1103576292pjhq-pixel/kwt/docs/reports/20261018-fixed-point-v1/README.md

# 定点方案比较与完整验证摘要

本目录归档 2026-10-18 实验 `20261018_fixed_point_v1` 的精简结果，不是本次资料整理重新运行的完整数值评测。完整矩阵、参数及原始比较明细仍在工作区 `generated/`。

尺度从 221 条训练输入的范围确定，增加 12.5% 幅值余量，再冻结配置。独立验证子集有 221 个输入；没有根据验证结果重新拟合尺度。模型固定提交为 `237e4097afd4f6851e0b82f0a8d65c2dfe8eae30`。

| 输入×权重 / 累加 / 输出 | 舍入 | 验证子集最差层 NRMSE | 验证子集最差单任务 NRMSE |
| --- | --- | ---: | ---: |
| 8×8 / 32 / 16 | RNE | 2.62043% | 4.11960% |
| 8×8 / 32 / 16 | 向零 | 5.67256% | 6.80097% |
| 16×8 / 32 / 16 | RNE | 2.36506% | 3.76023% |
| 16×8 / 32 / 16 | 向零 | 3.90772% | 5.45364% |
| 8×16 / 32 / 16 | RNE | 1.38383% | 1.71332% |
| 8×16 / 32 / 16 | 向零 | 3.06266% | 3.37268% |
| 12×12 / 32 / 16 | RNE | 0.16511% | 0.25230% |
| 12×12 / 32 / 16 | 向零 | 0.39294% | 0.50151% |
| 16×16 / 40 / 16 | RNE | 0.02064% | 0.03199% |
| 16×16 / 40 / 16 | 向零 | 0.04932% | 0.07298% |

选择 `i16_w16_a40_o16_rne` 作为起点，是为了精度余量和自然的 16 位存储；尚未证明它是面积或速度最优方案。12 位方案可作为后续资源对照。层汇总通过不保证每个矩阵任务通过，例如 8×8 的最差层低于 3%，但最差单任务高于 3%。

## 冻结后完整验证划分

- 原模型十二分类验证索引共 4445 条记录，实际计算 4075 个不同输入；一个全零波形按 371 条原始静音记录加权。
- 十二层最差汇总 NRMSE 为 **0.0211055%**；最差单输入、单层矩阵任务为 **0.0319907%**。
- 输入、输出、累加和偏置饱和计数全部为零，所有部分和界证明安全。
- 模型 162 个实际参数张量与 checkpoint 核对一致。

NRMSE 由平方误差和参考能量计算，不是分类错误率。4445 是原模型十二分类划分记录数，不是整个 35 词原始验证 WAV 数量。未用测试音频调参。

## 文件与复现入口

| 文件 | 含义 |
| --- | --- |
| [candidate_scales.json](candidate_scales.json) | 训练冻结的十组候选配置，保留原字节及历史工作区路径 |
| [comparison-summary.json](comparison-summary.json) | 十方案的训练/验证汇总；包含原 comparison.json 的 SHA-256 |
| [full_validation.json](full_validation.json) | 完整验证各层误差、计数、范围和原运行源码哈希 |
| [historical-audit.json](historical-audit.json) | 原运行审计记录；其中 19 项测试指历史运行 |
| [archive-manifest.json](archive-manifest.json) | 上述归档 JSON 的 SHA-256 |

配置文件 SHA-256：`d208f34b17da4db0a32fbdf21904e9c1739062f5389e24134e6f78a298f3e58a`。历史哈希用于核对原运行，不应在修改源码后重写。当前维护规格见 [数值格式 v0.1](../../shared/numeric-format-v0.1.md)。

重建数据需按 [环境说明](../../../config/environment/README.md) 准备模型和音频，再使用 `scripts/model/analyze_training_ranges.py`、`compare_fixed_point.py`、`full_fixed_point_validation.py`；先看各脚本 `--help`，新实验使用新的输出目录，勿覆盖原结果。

TensorFlow CPU 2.4.0 替代原始 2.4.0rc1，运行时等价性未证明。这些结果仅覆盖 FFN 第一线性层的数值模型；没有 RTL、面积、150 MHz 时序、整模型量化分类准确率或正式评测通过结论。
