1103576292pjhq-pixel/kwt/docs/reports/20261023-v07-accelerator/README.md

# 2026-10-23 V07独立加速器验证记录

本记录只针对`worktrees/ffn-v07-peripheral`中的本次实现。未合并、未推送；不是官方任务、真实语音精度、工艺面积或150MHz验收结论。

## 已执行并通过

| 测试 | 范围与结果 |
|---|---|
| 原计算核心 | 400 lane乘积；251转换用例加12拍连续转换；45块、1904输出握手 |
| 行为存储 | READ_LATENCY=1和2；各8480项X/W lane与bias检查 |
| 行为整机小矩阵 | M5/N32、两层；320项Y/flags/index，覆盖尾行、连续命令、背压、完成当拍BEGIN、非法命令和恢复 |
| 行为整机完整尺寸 | M99/N256、12个独立层任务；304128项Y/flags/index；第3个及之后的OPEN实际等待槽释放 |
| 实际宏小矩阵 | READ_LATENCY=1、M5/N32两层；存储8480项、整机320项通过 |
| 实际宏完整尺寸 | READ_LATENCY=2、M99/N256一层；存储8480项、整机25344项通过 |
| 两个整数参考交叉 | 12层304128项golden Y与个人fixed_point.py一致；Y及flags与队友fixed_numeric.py一致 |
| 个人整数模型测试 | test_fixed_point.py 7项通过 |
| 通用门级试综合 | Yosys0.9；默认M99/N256，USE_MACRO=1；hierarchy/check通过，12颗宏、未检测到锁存器 |

完整尺寸测试使用固定种子20261023的合成整数数据，交替小幅值/全范围数据，并含零行、正负bias、tie、饱和和任务身份差异；不把它说成12套真实预训练参数验证。生成目录manifest记录每个输入与golden文件的SHA-256。

## 试综合范围

使用本地`TS1N28HPCPL2SVTB2048X32M4MWBASO_tt1v25c.lib`作为SRAM库，12颗宏全部保留。每颗2048×32=8KiB，总物理实例容量96KiB；W的逻辑载荷虽只有4KiB，不能按4KiB计宏面积。

Yosys `synth -noabc`及`check -assert`通过。通用门级统计：61165 cells，含5007个$_DFF_P_和12颗SRAM宏；其余为通用AND/OR/XOR/NOT/MUX。未做标准单元映射、时钟约束、STA或功耗估算，不用通用门数推算正式mm²。

Yosys有两类预期警告：短的data_pipe/mask_pipe数组被转换为寄存器列表。这里是延迟寄存器，不是把X/W SRAM展开为触发器；最终12颗宏计数另行检查。

## 警告与限制

- 实际宏UNIT_DELAY模型在仿真0时刻报CEB初始化/退出shutdown顺序警告。未屏蔽警告，未修改宏模型；正常加载、运行、复位及中止流程功能比对通过。上电/睡眠/关断时序不在本版验收范围。
- 当前matrix_ctrl一次一个读请求在途，返回暂存后再供数；行为RAM一拍延迟时稳定供数间隔约3拍，两拍延迟约4拍。尚未实现每拍一组的预取优化。
- 没有64项结果缓冲，输出背压会延长当前块占用时间；这是已确定的初版组织。
- 独立输出握手表示接收方消费；未来SoC实际写回完成仍需总线层协议。

## 审阅与修正

独立只读审阅检查模块边界、槽释放、标签、尾行、背压和中止；指出完成周期BEGIN语义及测试缺口。新增测试先复现完成当拍BEGIN误报fault，再修正frontend与busy；补充连续命令、计算/受阻输出阶段协议故障取消测试，随后重跑完整12层。

## 依赖与隔离

四个计算文件和公共头文件与导入快照逐字节一致，没有改动。执行期间原计算工作树的mul_array_4x4.v被其他工作新增注释，本工作树保留已验证快照；其余四份依赖仍与源目录一致。这一源目录注释变化没有迁入本分支。

本地试验宏、下载的临时Yosys工具及大规模向量/网表均不放进源码提交，工具与产物分别在忽略的work/和out/中。接口与完整命令见../../shared/accelerator-v07-interface.md。
