1103576292pjhq-pixel/kwt/readme_sdc&scr.md

针对accelerator_top构造了可成功运行的flow与sdc。
WLM model：ZeroWireLoad   WLM mode：segmented
