1103576292pjhq-pixel/kwt/tests/fixtures/dot64-integration-v0.1/README.md

# 完整点积核心集成测试向量

共33个固定数值用例，无新增随机用例，也不需要重新下载音频或模型。

- 编号0～11：来自 `../dot64-v0.1/layer_00.json` 至 `layer_11.json`，为已有软件数值验证保存的12层真实诊断点积。原文件保留样本身份、行列位置和浮点参考；此处使用已量化的整数输入及整数期望值。
- 编号12～29：来自 `../dot64-v0.1/boundaries.json` 的18个人工边界用例，覆盖零、正负RNE半值及附近值、偏置边界、输出饱和、抵消和最后一项。
- 编号30：64对输入均为 x=256、w=256，bias=655360。累加后4849664，输出74。
- 编号31：64对输入均为 x=-256、w=256，bias=655360。累加后-3538944，输出-54。
- 编号32：仅k=63的x=w=256，其他输入均为0，bias=0。累加后65536，输出1，用于检查是否遗漏最后一个乘积。

前30个期望值沿用原固定向量，其来源清单记录了与 `scripts/model/fixed_point.py` 的交叉核对。新增3个期望值来自人工整数计算。本次入库又使用Python任意精度整数重算全部33个点积，并用 `divmod(acc,65536)` 的商、余数执行最近取整、中间值取偶数，再限制到[-32768,32767]；结果与保存的期望值一致。没有使用RTL输出生成期望值。

`x.hex`、`w.hex`各2112行，按用例编号依次排列，每例内部按k=0～63排列。其余3个hex文件各33行。所有文件均为定宽补码十六进制编码。`manifest.json`记录顺序、3个新增用例的完整输入、来源和SHA-256。

复位、中途clear、连续任务、输入暂停和DONE采样属于TB施加的时序场景，不是另外的音频或随机数值样本。33例之后，两次中止恢复检查分别复用第30、31例，因此共完成35次完整任务。

合法的64个signed16乘积加signed32偏置不会溢出signed40；这些外部输入不声称覆盖40位累加饱和事件。功能仿真不证明150MHz时序、面积或完整矩阵精度达标。
