1103576292pjhq-pixel/kwt/(commit log)

2026-10-16 feat: add KWT-1 accelerator prototype and validation reports
    Include the integer FFN1, public E203 integration, FP32 attention and
    twelve-layer encoder, pinned dependencies, and local validation evidence.
    Document all seven tasks, reproducible entry points, and formal evaluation
    items that remain pending. Restore four pinned upstream links during Linux
    preparation so Windows Git can manage the repository without LX symlinks.
    [case-results.csv, command-results.tsv, commands.tsv, layer-results.csv, rtl-case-results.csv, rtl-layer-results.csv]
2026-10-23 feat: add standalone V07 FFN1 accelerator with verified matrix pipeline
    Import the byte-verified modular INT16/Q12 x INT16/Q16 accelerator, software numeric model, fixtures and reproducible tests. Full M99 N256 twelve-layer synthetic regression checks 304128 Y/flags/index records; core, latency1/2, SRAM model and integer-reference checks pass. Document the standalone entry and differences from the historical SoC.
    [acc_context_bank.v, dot64_tile_core.v, mul_array_4x4.v]
2026-10-23 chore: keep standalone accelerator only and add synthesis entry
    Remove the historical team tree from this branch only. Keep the imported standalone RTL byte-identical, provide a canonical 12-file RTL list, Tcl source variables, a 150 MHz clock template and synthesis instructions. Verify import hashes, file-list compilation, Tcl parsing, core/buffer/accelerator tests and generic synthesis with 12 SRAM macros and no latches. Formal mapped timing/area remain pending.
    [analysis.csv, case-results.csv, classification.csv, command-results.tsv, commands.tsv, layer-results.csv, layer_metrics.csv, rtl-case-results.csv]
2026-10-25 feat: sync Verilog-2005 accelerator and LVT SRAM configuration
    Import the latest dot64-core development snapshot, replace peripheral .sv paths with .v, and align SRAM cell/model/Liberty references to TS1N28HPCPL2LVTB2048X32M4MWBASO tt0p9v25c. Update synthesis entry and source fingerprints. Fresh core, behavior RAM, LVT latency1/2, full M99 N256 LVT and generic synthesis checks pass. Formal timing and area remain unverified.
    [acc_context_bank.v, accelerator_top.v, command_frontend.v, matrix_ctrl.v, mul_array_4x4.v, result_ctrl.v, sram_wrapper.v, tb_accelerator.v]
2026-10-26 feat:add Synopsys DC synthesis flow for FFN V07
